microfarad-de/dashcam-controller/(commit log)

2026-07-18 Updated readme and added schematic
2026-07-19 Changed pin debounce algorithm to runing average
2026-07-19 Configured 8s watchdog timer
2026-07-19 Updated readme with power consumption
2026-07-19 Power reduction to 1.2 mA on genuine ATMega328p - Set all unused gpio to output low - Disable serial debugging
